elemental-platform/element-USB-gateway/README.md

# element-USB-gateway
Wireless USB gateway for RFM69 radio

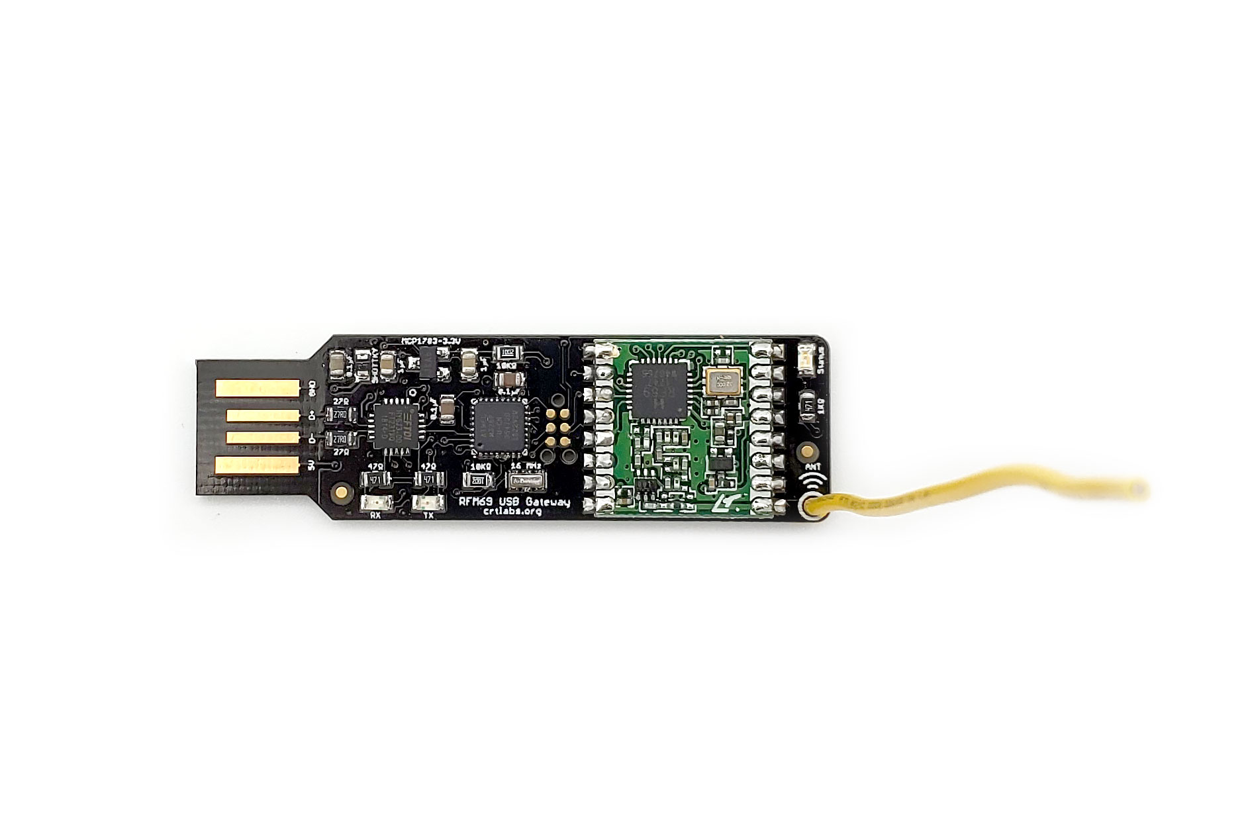
[picture p1: usb_gateway.jpg]
element USB gateway
