elemental-platform/element-USB-gateway/hardware/FSK_USB_Gateway.brd

## EAGLE design hardware/FSK_USB_Gateway.brd (2019-09-02)

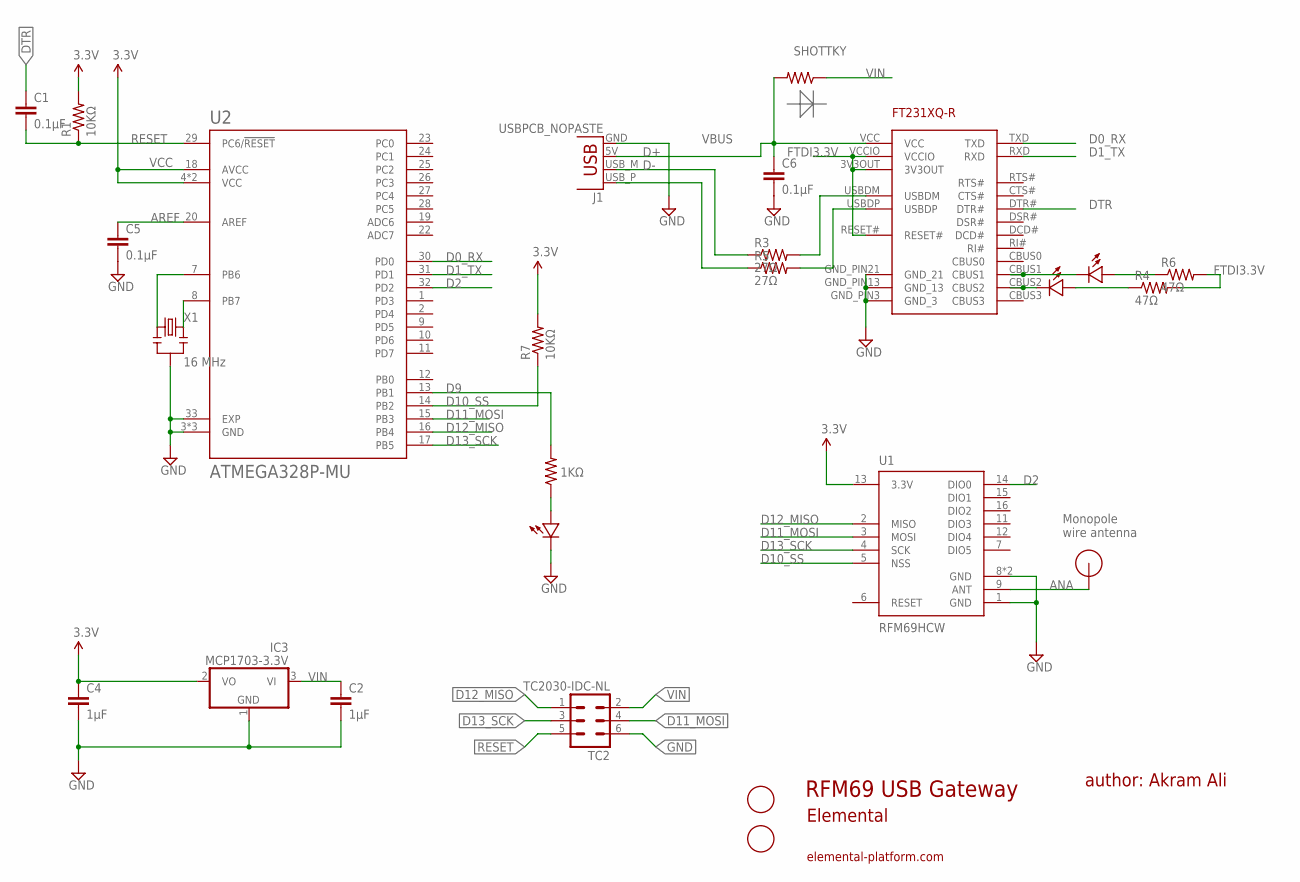
[picture p2: schematic FSK_USB_Gateway.sch, RFM 69 USB Gateway]

Parts:
C1, C5, C6: 0.1μF; 0805; MPN CC0805KRX7R9BB104
C2, C4: 1μF; 0805; MPN CC0805ZRY5V8BB105
D: SHOTTKY; 0805; MPN SD0805S040S0R5
FT231XQ-R: FT231XQ-R; FTDI_FT231XQ-R_PACKAGE; MPN FT231XQ-R
IC3: MCP1703-3.3V; SOT23; MPN MCP1703T-2502E/CB
J1: USBPCB_NOPASTE; USB-A-PCB-NOPASTE
R1, R7: 10KΩ; 0805; MPN RC0805FR-0710KL
R2: 1KΩ; 0805; MPN RC0805FR-071KL
R3, R5: 27Ω; 0805; MPN RC0805FR-0727RL
R4, R6: 47Ω; 0805; MPN RC0805FR-0747RL
RX: Green; 0805-LED; MPN LG R971-KN-1
TC2: TC2030-IDC-NL
TX: Red; 0805-LED; MPN LG R971-KN-1
U1: RFM69HCW; RFM69HCW-XXXS2; MPN RFM69HW
U2: ATMEGA328P-MU; QFN50P500X500X100-33N; MPN ATmega328P-MU
U$2: Status; 0805-LED; MPN LG R971-KN-1
U$3, U$4: FIDUCIAL; FIDUCIAL_1MM
U$6: RFM12B_ANTENNA; RFM12B-ANTENNA
X1: 16 MHz; RESONATOR-SMD; MPN CSTCE16M0V53-R0

Connections:
ANA: U1.9 (ANT), U$6.P$1
AREF: C5.1, U2.20 (AREF)
D0_RX: FT231XQ-R.TXD, U2.30 (PD0)
D1_TX: FT231XQ-R.RXD, U2.31 (PD1)
D2: U1.14 (DIO0), U2.32 (PD2)
D9: R2.2, U2.13 (PB1)
D10_SS: R7.1, U1.5 (NSS), U2.14 (PB2)
D11_MOSI: TC2.4, U1.3 (MOSI), U2.15 (PB3)
D12_MISO: TC2.1, U1.2 (MISO), U2.16 (PB4)
D13_SCK: TC2.3, U1.4 (SCK), U2.17 (PB5)
D+: J1.USB_P (D+), R5.1
D-: J1.USB_M (D-), R3.1
DTR: C1.1, FT231XQ-R.DTR#
FTDI3.3V: FT231XQ-R.3V3OUT, FT231XQ-R.RESET#, FT231XQ-R.VCCIO, R4.2, R6.2
GND: C2.2, C4.2, C5.2, C6.2, FT231XQ-R.GND_PIN3 (GND_3), FT231XQ-R.GND_PIN13 (GND_13), FT231XQ-R.GND_PIN21 (GND_21), IC3.1 (GND), J1.GND, TC2.6, U1.1 (GND), U1.8 (GND), U1.10 (GND), U2.3 (GND), U2.5 (GND), U2.21 (GND), U2.33 (EXP), U$2.MINUS, X1.2
unnamed: U2.7 (PB6), X1.1
unnamed: R2.1, U$2.PLUS
unnamed: FT231XQ-R.USBDM, R3.2
unnamed: FT231XQ-R.USBDP, R5.2
unnamed: FT231XQ-R.CBUS1, RX.MINUS
unnamed: FT231XQ-R.CBUS2, TX.MINUS
unnamed: R4.1, TX.PLUS
unnamed: R6.1, RX.PLUS
unnamed: U2.8 (PB7), X1.3
RESET: C1.2, R1.1, TC2.5, U2.29 (PC6/!RESET)
VBUS: C6.1, D.2, FT231XQ-R.VCC, J1.5V (VBUS)
VCC: C4.1, IC3.2 (VO), R1.2, R7.2, U1.13 (3.3V), U2.4 (VCC), U2.6 (VCC), U2.18 (AVCC)
VIN: C2.1, D.1, IC3.3 (VI), TC2.2

Notes on the sheet:
RFM69 USB Gateway
author: Akram Ali
Elemental
Monopole wire antenna
elemental-platform.com

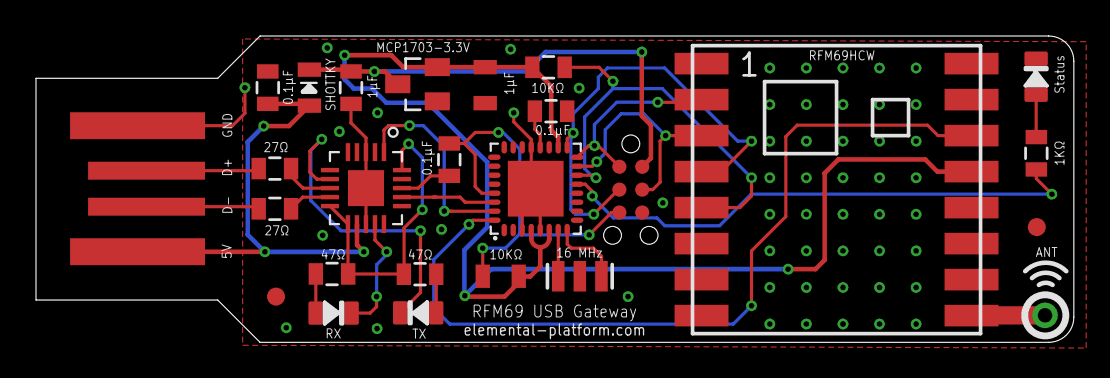
[picture p3: board FSK_USB_Gateway.brd from above]

Board: 2 copper layers, 57.7 x 17.0 mm, 26 parts (0 on the bottom side), 28 nets.
