elemental-platform/element-USB-gateway/(commit log)

2020-01-20 Update firmware.ino
    - fixed error where message was lost. Added proper null termination in strings
    - reorganized code a bit
    [firmware.ino]
2020-01-22 Update firmware.ino
    - added fade LED on boot to indicate power on
    - clean up and reorganized code a bit
2020-01-23 major update
    - changed encryption key to avoid interference with other nodes while updating
    [firmware.ino]
